landonh12/SensorHubBoard/production/bom_final.xls

Comment | Designator | Footprint | JLCPCB Part #
NRST | SW1 | SW_TS-1088-AR02016 | C720477
D_Schottky | D5,D6 | 0603 | C143772
4.7uF | C16 | 0805 | C1779
TPS5430DDA | U1 | TI_SO-PowerPAD-8_ThermalVias | C9864
150 | R6 | 0402 | C25756
USB_C_Receptacle_USB2.0_14P | J4 | USB_C_Receptacle_GCT_USB4110 | C2840392
100 | R4,R5 | 0402 | C25076
TCAN1042DRQ1 | U2 | SOIC-8_3.9x4.9mm_P1.27mm | C485806
3.24k | R11 | 0402 | C11457
LED | D2 | 0805 | C84256
2.2uF | C8,C9 | 0402 | C12530
4.7uF | C15,C20 | 0603 | C19666
LED | D1 | 0805 | C2297
PMOS | Q3 | SOT-23 | C15127
W25Q32JVZP | U3 | WSON-8-1EP_6x5mm_P1.27mm_EP3.4x4.3mm | C571260
2pF | C3,C4 | 0402 | C1558
32.768KHz | X2 | Crystal_SMD_3215-2Pin_3.2x1.5mm | C156244
4.3pF | C1,C2 | 0402 | C56585
STM32F722VETx | U7 | LQFP-100_14x14mm_P0.5mm | C132372
10uF | C17,C18,C23,C24 | 0603 | C19702
Conn_01x04 | J1,J2,J3 | JST_SH_SM04B-SRSS-TB_1x04-1MP_P1.00mm_Horizontal | C7433425
8MHz | X1 | Crystal_SMD_3225-2Pin_3.2x2.5mm | C889706
0.1uF | C10,C11,C12,C13,C14,C19,C21,C22,C25,C26,C5,C10,C11,C12,C13,C14,C19,C21,C22,C25,C26,C5,C27 | 0402 | C1525
15uH | L1 | L_Sumida_CDMC6D28_7.25x6.5mm | C5189936
5.1k | R10,R9 | 0402 | C25905
220uF | C7 | CP_EIA-3528-21_Kemet-B | C30242
10nF | C6 | 0402 | C15195
AZ1117-3.3 | U4 | SOT-223-3_TabPin2 | C6186
LED | D3 | 0805 | C34499
10k | R16,R12,R13,R14,R15,R8,R16,R12,R13,R14,R15,R8,R17 | 402 | C25744
NMOS | Q1,Q2 | SOT-23 | C10487
100k | R18 | 402 | C25530
