landonh12/SensorHubBoard/CAN-Sensor-Hub-v1.kicad_pcb

## KiCad design CAN-Sensor-Hub-v1.kicad_pcb (2025-07-02)

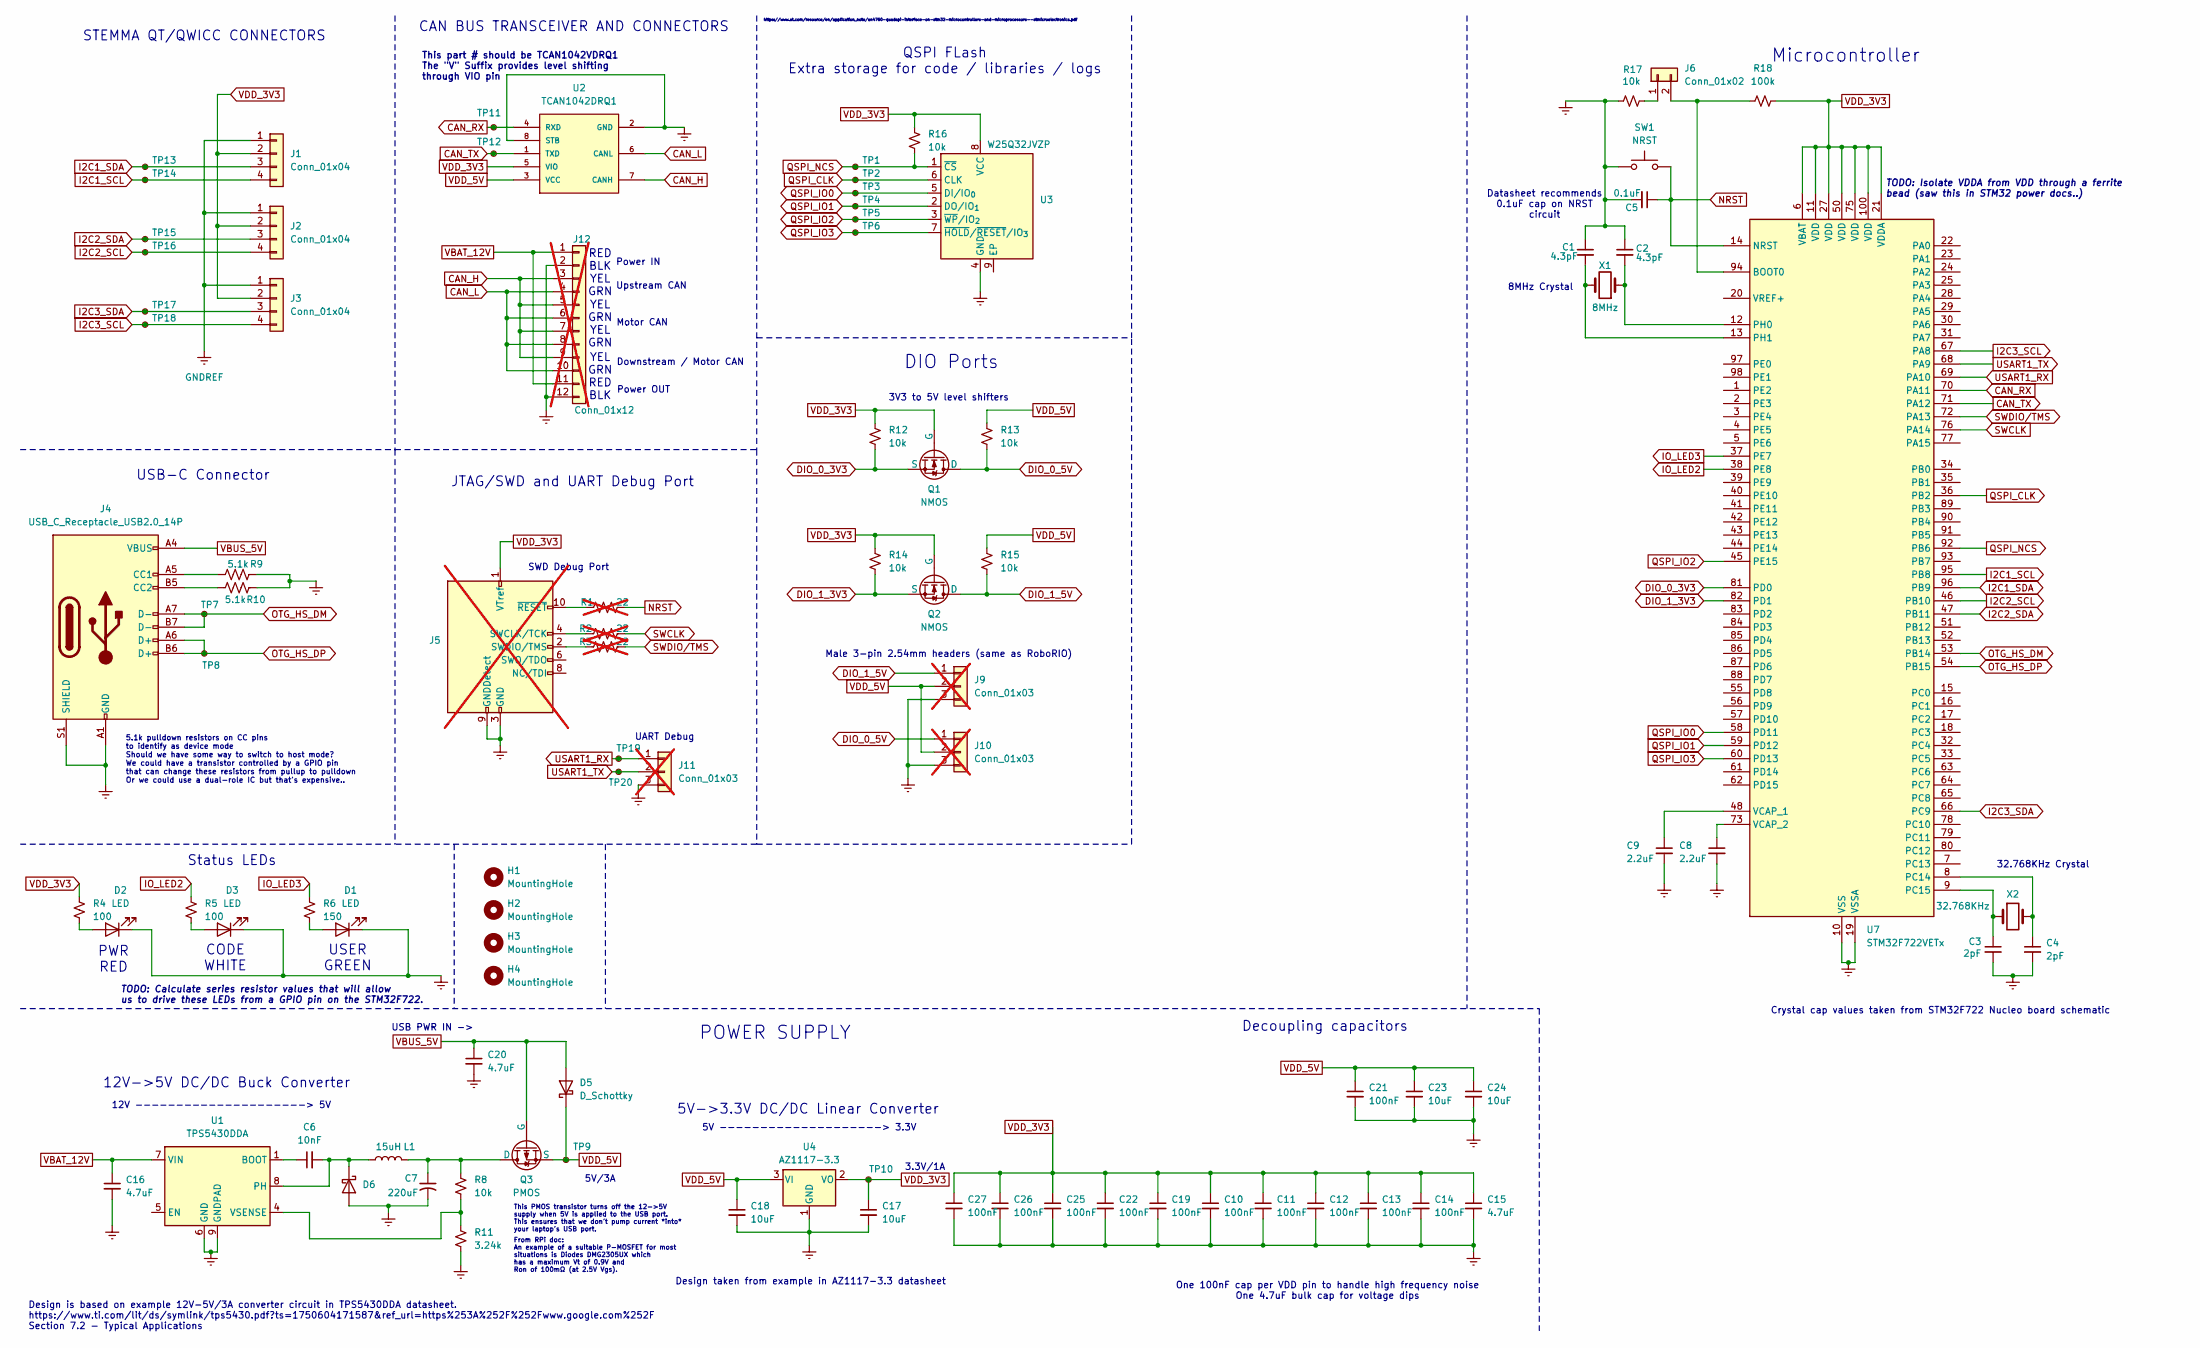
[picture p1: schematic CAN-Sensor-Hub-v1.kicad_sch]

Parts:
C1, C2: 4.3pF; C_0402_1005Metric; LCSC CL05C100JB5NNNC
C3, C4: 2pF; C_0402_1005Metric; LCSC 0402CG2R0C500NT
C5: 0.1uF; C_0402_1005Metric; LCSC CL05B104KO5NNNC
C6: 10nF; C_0402_1005Metric; LCSC CL05B103KB5NNNC
C7: 220uF; CP_EIA-3528-21_Kemet-B
C8, C9: 2.2uF; C_0402_1005Metric; LCSC CL05A225MQ5NSNC
C10, C11, C12, C13, C14, C19, C21, C22, C25, C26, C27: 100nF; C_0402_1005Metric; LCSC CL05B104KO5NNNC
C15, C20: 4.7uF; C_0603_1608Metric; LCSC CL10A475KO8NNNC
C16: 4.7uF; C_0805_2012Metric; LCSC CL21A475KAQNNNE
C17, C18, C23, C24: 10uF; C_0603_1608Metric; LCSC CL10A106MA8NRNC
D1: LED; LED_0805_2012Metric; LCSC KT-0805G
D2: LED; LED_0805_2012Metric; LCSC NCD0805R1
D3: LED; LED_0805_2012Metric; LCSC KT-0805W
D5, D6: D_Schottky; D_0603_1608Metric; LCSC SD0603S040S0R2
H1, H2, H3, H4: MountingHole; MountingHole_2.7mm_M2.5
J1, J2, J3: Conn_01x04; JST_SH_SM04B-SRSS-TB_1x04-1MP_P1.00mm_Horizontal; LCSC SM04B-SRSS-TB(LF)(SN)
J4: USB_C_Receptacle_USB2.0_14P; USB_C_Receptacle_GCT_USB4110; LCSC TYPEC-304YSSW-ACP16
J5: Conn_ARM_JTAG_SWD_10; PinHeader_2x05_P1.27mm_Vertical_SMD; not fitted
J6: Conn_01x02; PinHeader_1x02_P2.54mm_Vertical
J9, J10: Conn_01x03; PinHeader_1x03_P2.54mm_Horizontal; not fitted
J11: Conn_01x03; PinHeader_1x03_P2.54mm_Vertical; not fitted
J12: Conn_01x12; TerminalBlock_WAGO_2601-1112_1x12_P3.50mm_Horizontal; not fitted
L1: 15uH; L_Sumida_CDMC6D28_7.25x6.5mm; LCSC CYA0650-15UH
Q1, Q2: NMOS; SOT-23; LCSC SI2301CDS-T1-GE3
Q3: PMOS; SOT-23; LCSC AO3401A
R1, R2, R3: 22; R_0805_2012Metric; not fitted
R4, R5: 100; R_0402_1005Metric; LCSC 0402WGF1000TCE
R6: 150; R_0402_1005Metric; LCSC 0402WGF1500TCE
R8, R12, R13, R14, R15, R17: 10k; R_0402_1005Metric; LCSC 0402WGF1002TCE
R9, R10: 5.1k; R_0402_1005Metric; LCSC 0402WGF5101TCE
R11: 3.24k; R_0402_1005Metric; LCSC 0402WGF3241TCE
R16: 10k; R_0402_1005Metric
R18: 100k; R_0402_1005Metric; LCSC 0402WGF1002TCE
SW1: NRST; SW_TS-1088-AR02016; LCSC TS-1088-AR02016
TP1, TP2, TP3, TP4, TP5, TP6, TP7, TP8, TP9, TP10, TP11, TP12, TP13, TP14, TP15, TP16, TP17, TP18, TP19, TP20: TestPoint_Small; TestPoint_Pad_D0.5mm
U1: TPS5430DDA; TI_SO-PowerPAD-8_ThermalVias; LCSC TPS5430DDAR
U2: TCAN1042DRQ1; SOIC-8_3.9x4.9mm_P1.27mm; PARTNUMBER TCAN1042DRQ1
U3: W25Q32JVZP; WSON-8-1EP_6x5mm_P1.27mm_EP3.4x4.3mm; LCSC W25Q32JVZPIQ
U4: AZ1117-3.3; SOT-223-3_TabPin2; LCSC AMS1117-3.3
U7: STM32F722VETx; LQFP-100_14x14mm_P0.5mm; LCSC STM32F722VET6
X1: 8MHz; Crystal_SMD_3225-2Pin_3.2x2.5mm; LCSC NX3225GD-8MHZ-STD-CRA-3
X2: 32.768KHz; Crystal_SMD_3215-2Pin_3.2x1.5mm; LCSC NX3215SA-32.768K-STD-MUA-14

Connections:
CAN_H: J12.3, J12.5, J12.7, J12.9, U2.7 (CANH)
CAN_L: J12.4, J12.6, J12.8, J12.10, U2.6 (CANL)
CAN_RX: TP11.1, U2.4 (RXD), U7.70 (PA11)
CAN_TX: TP12.1, U2.1 (TXD), U7.71 (PA12)
DIO_0_3V3: Q1.3 (S), R12.2, U7.81 (PD0)
DIO_0_5V: J10.1, Q1.1 (D), R13.2
DIO_1_3V3: Q2.3 (S), R14.2, U7.82 (PD1)
DIO_1_5V: J9.1, Q2.1 (D), R15.2
GNDREF: C1.1, C2.1, C3.2, C4.2, C5.2, C7.2, C8.2, C9.2, C10.2, C11.2, C12.2, C13.2, C14.2, C15.2, C16.2, C17.2, C18.2, C19.2, C20.2, C21.2, C22.2, C23.2, C24.2, C25.2, C26.2, C27.2, D1.1 (K), D2.1 (K), D3.1 (K), D6.2 (A), J1.1, J2.1, J3.1, J4.A1 (GND), J4.A12 (GND), J4.B1 (GND), J4.B12 (GND), J4.S1 (SHIELD), J5.3 (GND), J5.5 (GND), J5.9 (GNDDetect), J9.3, J10.3, J11.3, J12.2, J12.12, R9.2, R10.2, R11.2, R17.1, SW1.1, U1.6 (GND), U1.9 (GNDPAD), U2.2 (GND), U2.8 (STB), U3.4 (GND), U4.1 (GND), U7.10 (VSS), U7.19 (VSSA), U7.26 (VSS), U7.49 (VSS), U7.74 (VSS), U7.99 (VSS)
I2C1_SCL: J1.4, TP14.1, U7.95 (PB8)
I2C1_SDA: J1.3, TP13.1, U7.96 (PB9)
I2C2_SCL: J2.4, TP16.1, U7.46 (PB10)
I2C2_SDA: J2.3, TP15.1, U7.47 (PB11)
I2C3_SCL: J3.4, TP18.1, U7.67 (PA8)
I2C3_SDA: J3.3, TP17.1, U7.66 (PC9)
IO_LED1: U7.39 (PE9)
IO_LED2: R5.1, U7.38 (PE8)
IO_LED3: R6.1, U7.37 (PE7)
NRST: C5.1, R1.2, SW1.2, U7.14 (NRST)
unnamed: D1.2 (A), R6.2
unnamed: D2.2 (A), R4.2
unnamed: D3.2 (A), R5.2
unnamed: C6.2, D6.1 (K), L1.1, U1.8 (PH)
unnamed: J4.A5 (CC1), R9.1
unnamed: J4.B5 (CC2), R10.1
unnamed: J5.4 (SWCLK/TCK), R2.1
unnamed: J5.2 (SWDIO/TMS), R3.1
unnamed: J5.10 (~RESET), R1.1
unnamed: J6.1, R17.2
unnamed: J6.2, R18.1, U7.94 (BOOT0)
unnamed: C7.1, L1.2, Q3.1 (D), R8.1
unnamed: C6.1, U1.1 (BOOT)
unnamed: R8.2, R11.1, U1.4 (VSENSE)
unnamed: C4.1, U7.8 (PC14), X2.2
unnamed: C3.1, U7.9 (PC15), X2.1
unnamed: C2.2, U7.12 (PH0), X1.1
unnamed: C1.2, U7.13 (PH1), X1.2
unnamed: C9.1, U7.48 (VCAP_1)
unnamed: C8.1, U7.73 (VCAP_2)
OTG_HS_DM: J4.A7 (D-), J4.B7 (D-), TP7.1, U7.53 (PB14)
OTG_HS_DP: J4.A6 (D+), J4.B6 (D+), TP8.1, U7.54 (PB15)
QSPI_CLK: TP2.1, U3.6 (CLK), U7.36 (PB2)
QSPI_IO0: TP3.1, U3.5 (DI/IO_{0}), U7.58 (PD11)
QSPI_IO1: TP4.1, U3.2 (DO/IO_{1}), U7.59 (PD12)
QSPI_IO2: TP5.1, U3.3 (~WP/IO_{2}), U7.45 (PE15)
QSPI_IO3: TP6.1, U3.7 (~HOLD/~RESET/IO_{3}), U7.60 (PD13)
QSPI_NCS: R16.2, TP1.1, U3.1 (~CS), U7.92 (PB6)
SWCLK: R2.2, U7.76 (PA14)
SWDIO/TMS: R3.2, U7.72 (PA13)
USART1_RX: J11.1, TP19.1, U7.69 (PA10)
USART1_TX: J11.2, TP20.1, U7.68 (PA9)
VBAT_12V: C16.1, J12.1, J12.11, U1.7 (VIN)
VBUS_5V: C20.1, D5.2 (A), J4.A4 (VBUS), J4.A9 (VBUS), J4.B4 (VBUS), J4.B9 (VBUS), Q3.2 (G)
VDD_3V3: C10.1, C11.1, C12.1, C13.1, C14.1, C15.1, C17.1, C19.1, C22.1, C25.1, C26.1, C27.1, J1.2, J2.2, J3.2, J5.1 (VTref), Q1.2 (G), Q2.2 (G), R4.1, R12.1, R14.1, R16.1, R18.2, TP10.1, U2.5 (VIO), U3.8 (VCC), U4.2 (VO), U7.6 (VBAT), U7.11 (VDD), U7.21 (VDDA), U7.27 (VDD), U7.50 (VDD), U7.75 (VDD), U7.100 (VDD)
VDD_5V: C18.1, C21.1, C23.1, C24.1, D5.1 (K), J9.2, J10.2, Q3.3 (S), R13.1, R15.1, TP9.1, U2.3 (VCC), U4.3 (VI)

Notes on the sheet:
Datasheet recommends 0.1uF cap on NRST circuit
Microcontroller
8MHz Crystal
3V3 to 5V level shifters
5V --------------------> 3.3V
Motor CAN
Decoupling capacitors
YEL GRN RED BLK
USB-C Connector
Power OUT
PWR RED
12V ---------------------> 5V
5.1k pulldown resistors on CC pins to identify as device mode Should we have some way to switch to host mode? We could have a transistor controlled by a GPIO pin that can change these resistors from pullup to pulldown Or we could use a dual-role IC but that's expensive..
Status LEDs
TODO: Isolate VDDA from VDD through a ferrite bead (saw this in STM32 power docs..)
UART Debug
One 100nF cap per VDD pin to handle high frequency noise One 4.7uF bulk cap for voltage dips
RED BLK YEL GRN
Power IN
Design is based on example 12V-5V/3A converter circuit in TPS5430DDA datasheet. https://www.ti.com/lit/ds/symlink/tps5430.pdf?ts=1750604171587&ref_url=https%253A%252F%252Fwww.google.com%252F Section 7.2 - Typical Applications
USB PWR IN ->
This PMOS transistor turns off the 12->5V supply when 5V is applied to the USB port. This ensures that we don't pump current *into* your laptop's USB port.
STEMMA QT/QWICC CONNECTORS
CODE WHITE
This part # should be TCAN1042VDRQ1 The "V" Suffix provides level shifting through VIO pin
DIO Ports
QSPI FLash Extra storage for code / libraries / logs
3.3V/1A
Design taken from example in AZ1117-3.3 datasheet
CAN BUS TRANSCEIVER AND CONNECTORS
32.768KHz Crystal
5V->3.3V DC/DC Linear Converter
USER GREEN
https://www.st.com/resource/en/application_note/an4760-quadspi-interface-on-stm32-microcontrollers-and-microprocessors--stmicroelectronics.pdf
YEL GRN YEL GRN
5V/3A
POWER SUPPLY
JTAG/SWD and UART Debug Port
Upstream CAN
Downstream / Motor CAN
Male 3-pin 2.54mm headers (same as RoboRIO)
SWD Debug Port
TODO: Calculate series resistor values that will allow us to drive these LEDs from a GPIO pin on the STM32F722.
12V->5V DC/DC Buck Converter
Crystal cap values taken from STM32F722 Nucleo board schematic
From RPi doc: An example of a suitable P-MOSFET for most situations is Diodes DMG2305UX which has a maximum Vt of 0.9V and Ron of 100mΩ (at 2.5V Vgs).

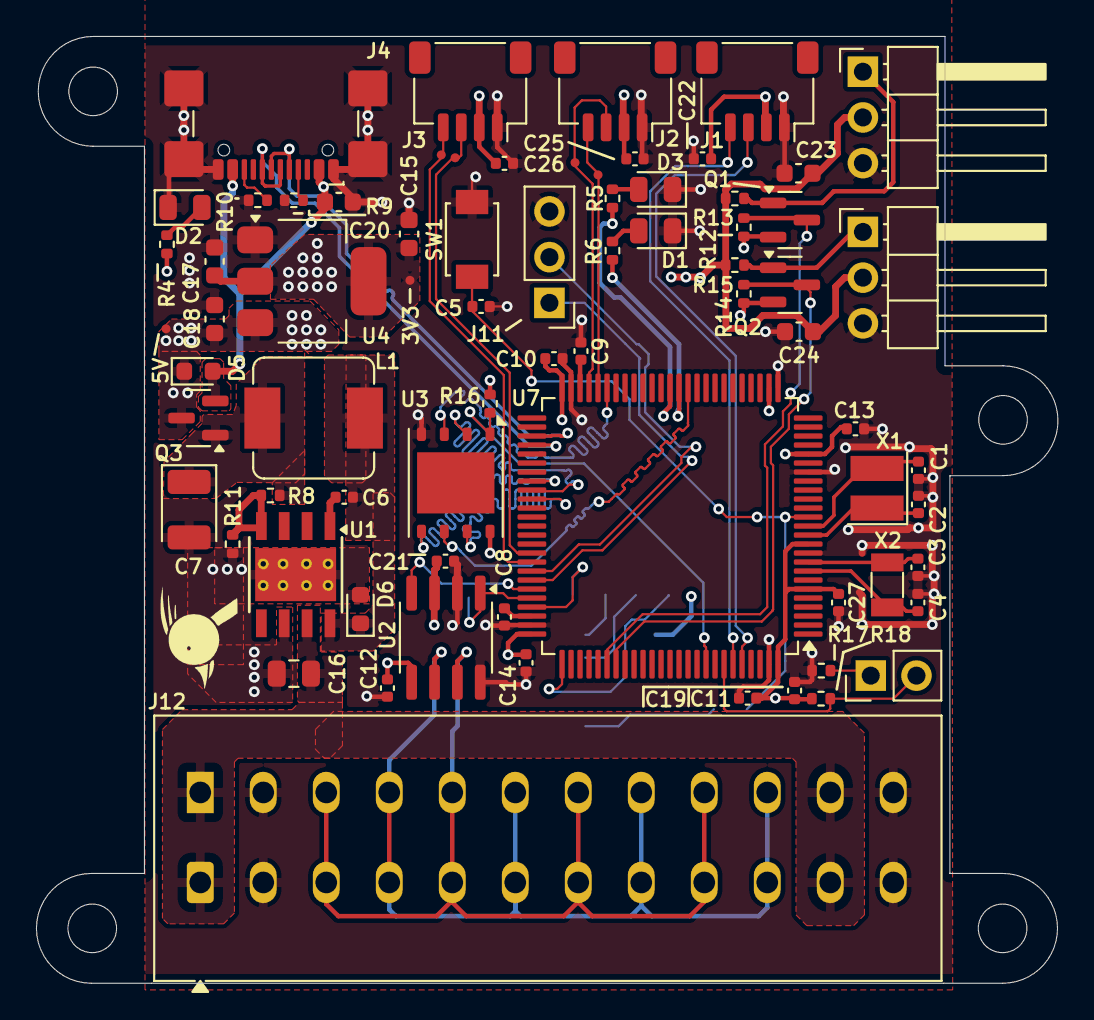
[picture p2: board CAN-Sensor-Hub-v1.kicad_pcb from above]

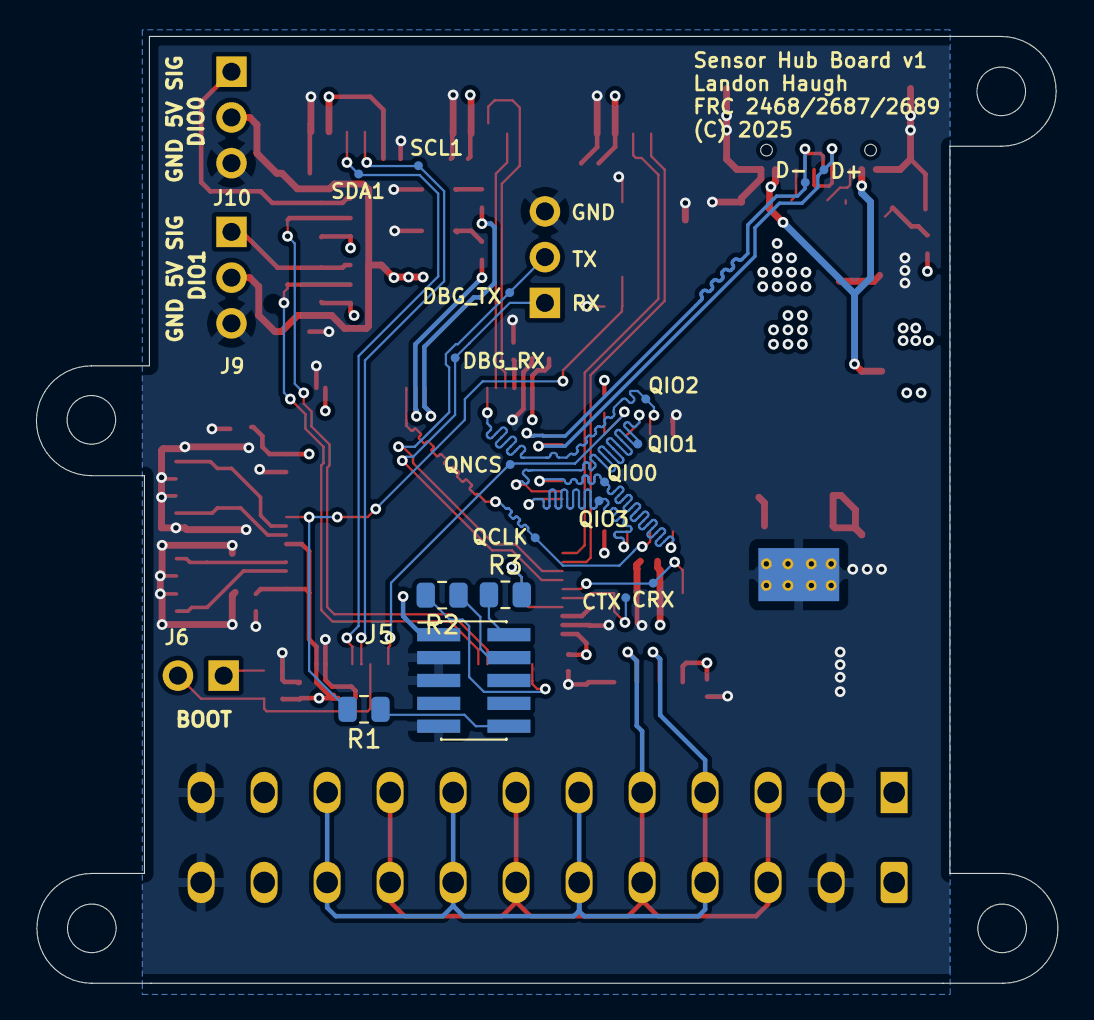
[picture p3: board CAN-Sensor-Hub-v1.kicad_pcb from below]

Board: 4 copper layers, 56.8 x 52.6 mm, 95 parts (18 on the bottom side), 54 nets.
