landonh12/SensorHubBoard/(commit log)

2025-06-22 Cleaned up schematic, added 5V->3V linear converter
    [CAN-Sensor-Hub-v1.kicad_sch]
2025-06-24 Updated schematic, added PCB file with footprints assigned and started experimenting
    [CAN-Sensor-Hub-v1.kicad_pcb, CAN-Sensor-Hub-v1.kicad_sch]
2025-06-27 Initial prototype layout done - likely needs to be redone
    [CAN-Sensor-Hub-v1.kicad_pcb, CAN-Sensor-Hub-v1.kicad_sch]
2025-07-01 V0.2 of board, nearly ready for production
    [CAN-Sensor-Hub-v1.kicad_pcb, CAN-Sensor-Hub-v1.kicad_sch]
2025-07-02 Production ready board
    [CAN-Sensor-Hub-v1-B_Cu.gbr, CAN-Sensor-Hub-v1-B_Mask.gbr, CAN-Sensor-Hub-v1-B_Paste.gbr, CAN-Sensor-Hub-v1-B_Silkscreen.gbr, CAN-Sensor-Hub-v1-Edge_Cuts.gbr, CAN-Sensor-Hub-v1-F_Cu.gbr, CAN-Sensor-Hub-v1-F_Mask.gbr, CAN-Sensor-Hub-v1-F_Paste.gbr]
2025-07-02 Made some more adjustments .. USART2 is not compatible with bootloader, changed to USART1
    [CAN-Sensor-Hub-v1.kicad_pcb, CAN-Sensor-Hub-v1.kicad_sch]
