landonh12/SensorHubBoard/(notices)

Notices in the files:
CAN-Sensor-Hub-v1.kicad_pcb:
(C) 2025
